landjas09/SPECTRA-MX-1-/BOM/Spectra Mx-1.csv

Reference | Qty | Value | Footprint | Manufacturer_Part_Number | MANUFACTURER
C100,C101,C206,C207,C402 | 5 | 1u | Capacitor_SMD:C_0603_1608Metric
C102,C103,C104,C105,C107 | 5 | 22u | Capacitor_SMD:C_0805_2012Metric
C106 | 1 | DNP | Capacitor_SMD:C_0402_1005Metric
C108,C201,C202,C203,C204,C210,C211,C212,C301,C302,C306,C311,C313,C314,C401,C405 | 16 | 100n | Capacitor_SMD:C_0402_1005Metric
C200,C308,C309,C310,C312,C315,C400 | 7 | 10u | Capacitor_SMD:C_0603_1608Metric
C205 | 1 | 10n | Capacitor_SMD:C_0402_1005Metric
C208,C209 | 2 | 10p | Capacitor_SMD:C_0402_1005Metric
C300,C304,C307,C404 | 4 | 150p | Capacitor_SMD:C_0402_1005Metric
C303,C305,C403,C406 | 4 | 1n | Capacitor_SMD:C_0402_1005Metric
D100 | 1 | GREEN | LED_SMD:LED_0603_1608Metric
D206 | 1 | LED_ARGB | LED_SMD:LED_RGB_Wuerth-PLCC4_3.2x2.8mm_150141M173100
J200 | 1 | Conn_02x05_Odd_Even | Connector_PinHeader_1.27mm:PinHeader_2x05_P1.27mm_Vertical
J201 | 1 | USB_C_Receptacle_USB2.0_16P | Connector_USB:USB_C_Receptacle_GCT_USB4105-xx-A_16P_TopMnt_Horizontal
J300,J400 | 2 | Conn_Coaxial | Connector_Coaxial:BNC_Amphenol_B6252HB-NPP3G-50_Horizontal
L100 | 1 | 100n | Inductor_SMD:L_0402_1005Metric
L101 | 1 | MWSA0603S-150MT | Footprints:INDM7066X300N |  | Shenzhen Sunlord Electronics Co. Ltd.
L200 | 1 | CMF3216F-900-2P-T | Footprints:CMC-1206
L201 | 1 | 10n | Inductor_SMD:L_0402_1005Metric
R100 | 1 | 10R | Resistor_SMD:R_0805_2012Metric
R101 | 1 | 100k | Resistor_SMD:R_0402_1005Metric
R102,R304,R403 | 3 | 22k | Resistor_SMD:R_0402_1005Metric
R103,R104,R105,R300,R306,R307 | 6 | 1k | Resistor_SMD:R_0402_1005Metric
R200,R202,R203,R402 | 4 | 10k | Resistor_SMD:R_0402_1005Metric
R201,R309,R400 | 3 | 0R | Resistor_SMD:R_0402_1005Metric
R204 | 1 | 1k5 | Resistor_SMD:R_0402_1005Metric
R205,R206 | 2 | 5k1 | Resistor_SMD:R_0402_1005Metric
R207,R208,R209 | 3 | 1K | Resistor_SMD:R_0402_1005Metric
R210,R211,R212,R213,R308,R405 | 6 | 49R9 | Resistor_SMD:R_0402_1005Metric
R301,R302 | 2 | 2M2 | Resistor_SMD:R_0402_1005Metric
R303,R401 | 2 | 6k8 | Resistor_SMD:R_0402_1005Metric
R305,R404 | 2 | 12k | Resistor_SMD:R_0402_1005Metric
U100 | 1 | TLV62569DBVR | Footprints:TLV-SOT95P280X145-5N
U101 | 1 | HT7533-1 | Footprints:LDO-SOT89
U102,U300,U301,U401 | 4 | MCP6001U | Package_TO_SOT_SMD:SOT-23-5
U200 | 1 | STM32F103CBTx | Footprints:STM-LQFP-48_7x7mm_P0.5mm
U201 | 1 | USBLC6-2SC6 | Package_TO_SOT_SMD:SOT-23-6
U302 | 1 | ADC141S626CIMM/NOPB | Footprints:SOIC-10-adc141s626
U303 | 1 | REF3033 | Package_TO_SOT_SMD:SOT-23
U400 | 1 | DAC7563SDGSR | Footprints:SOIC-10-adc141s626
Y200 | 1 | 16Mhz | Crystal:Crystal_SMD_3225-4Pin_3.2x2.5mm
D200,D201,D203,D204,D205,D300,D400 | 7 | CDSOD323-T03C | Footprints:SOD2513X114N | CDSOD323-T03C
