landjas09/SPECTRA-MX-1-/BOM/note.txt

manufacturer names and exact manufacturer part numbers (MPNs) have not yet been finalized for all components.
