landjas09/SPECTRA-MX-1-/3D/CDSOD323-T03C.stp

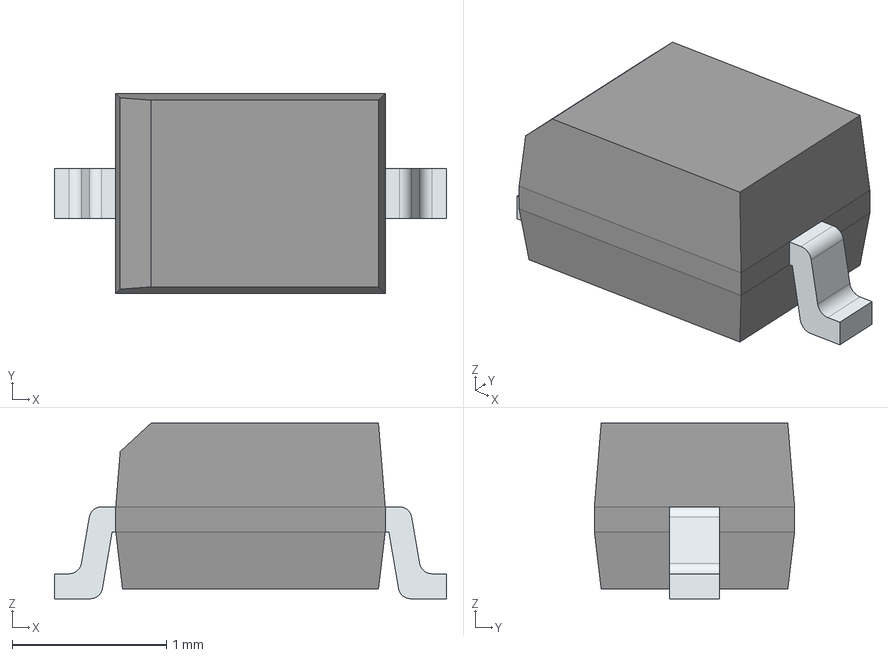
[picture p6: CAD file, 2026-10-12]
3D/CDSOD323-T03C.stp
2.54 x 1.30 x 1.14 mm
FilletPinL
FilletPinR
