landjas09/SPECTRA-MX-1-/3D/WE-CNSW_1206.step

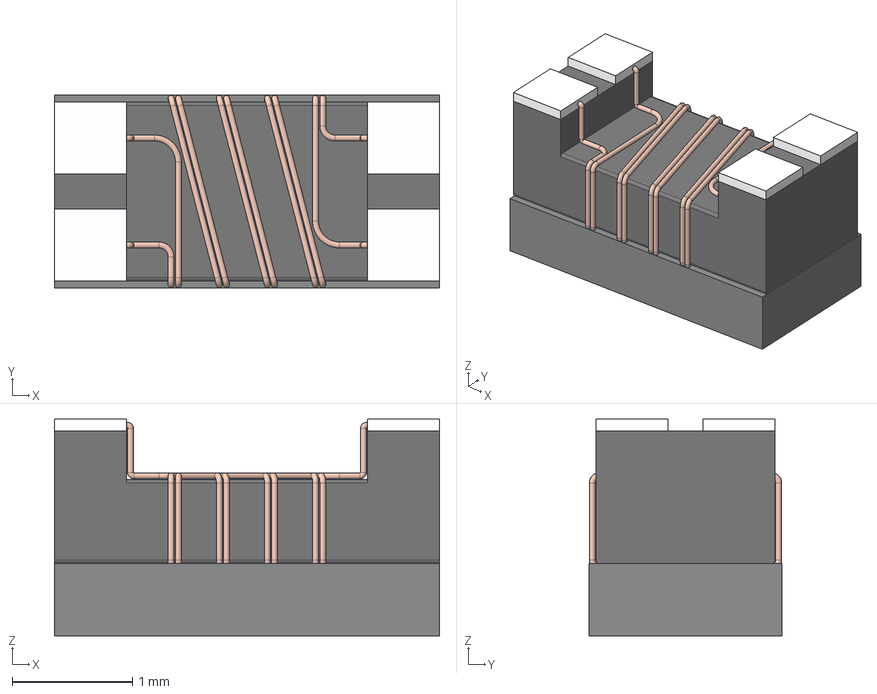
[picture p7: CAD file, 2026-10-12]
3D/WE-CNSW_1206.step
3.20 x 1.60 x 1.80 mm
Gehäuse x 3
Boden
Lötfläche x 4
