landjas09/SPECTRA-MX-1-/3D/CMF3216F-900-2P-T.step

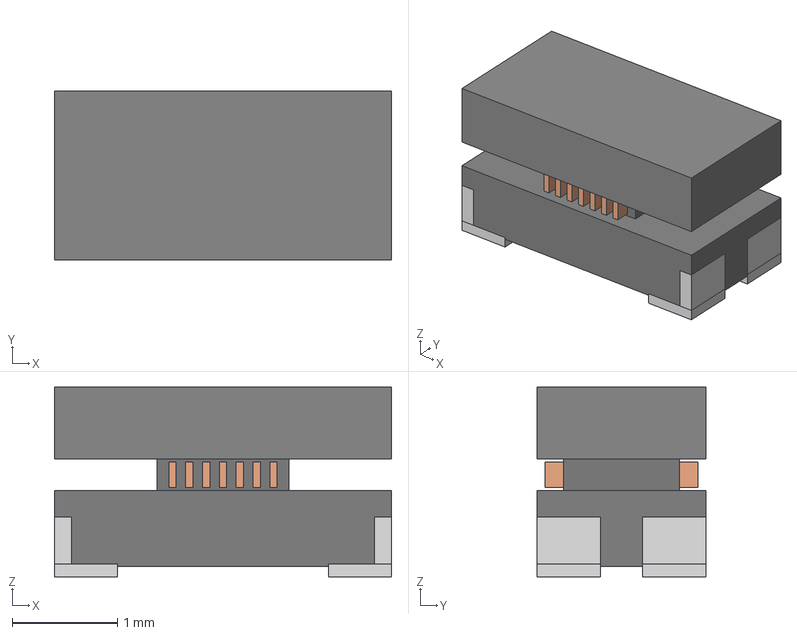
[picture p8: CAD file, 2026-10-12]
3D/CMF3216F-900-2P-T.step
3.20 x 1.60 x 1.80 mm
Lower_Ferrite
Upper_Ferrite
Core
Terminal_-1_-1_foot
Terminal_-1_-1_tab
Terminal_-1_1_foot
Terminal_-1_1_tab
Terminal_1_-1_foot
Terminal_1_-1_tab
Terminal_1_1_foot
Terminal_1_1_tab
CopperWinding_0
CopperWinding_1
CopperWinding_2
CopperWinding_3
CopperWinding_4
CopperWinding_5
CopperWinding_6
