landjas09/SPECTRA-MX-1-/3D/IND_MWSA0603S_SNL.step

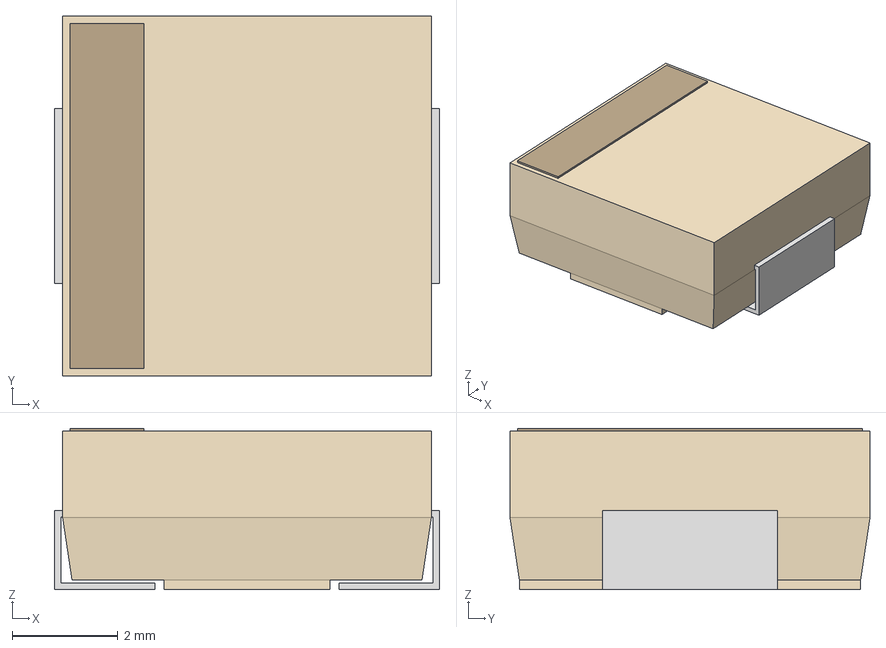
[picture p9: CAD file, 2026-10-12]
3D/IND_MWSA0603S_SNL.step
7.29 x 6.81 x 3.05 mm
