landjas09/SPECTRA-MX-1-/MixedSignal_Analyzer_Generator.kicad_pcb

## KiCad design MixedSignal_Analyzer_Generator.kicad_pcb (2026-10-12)

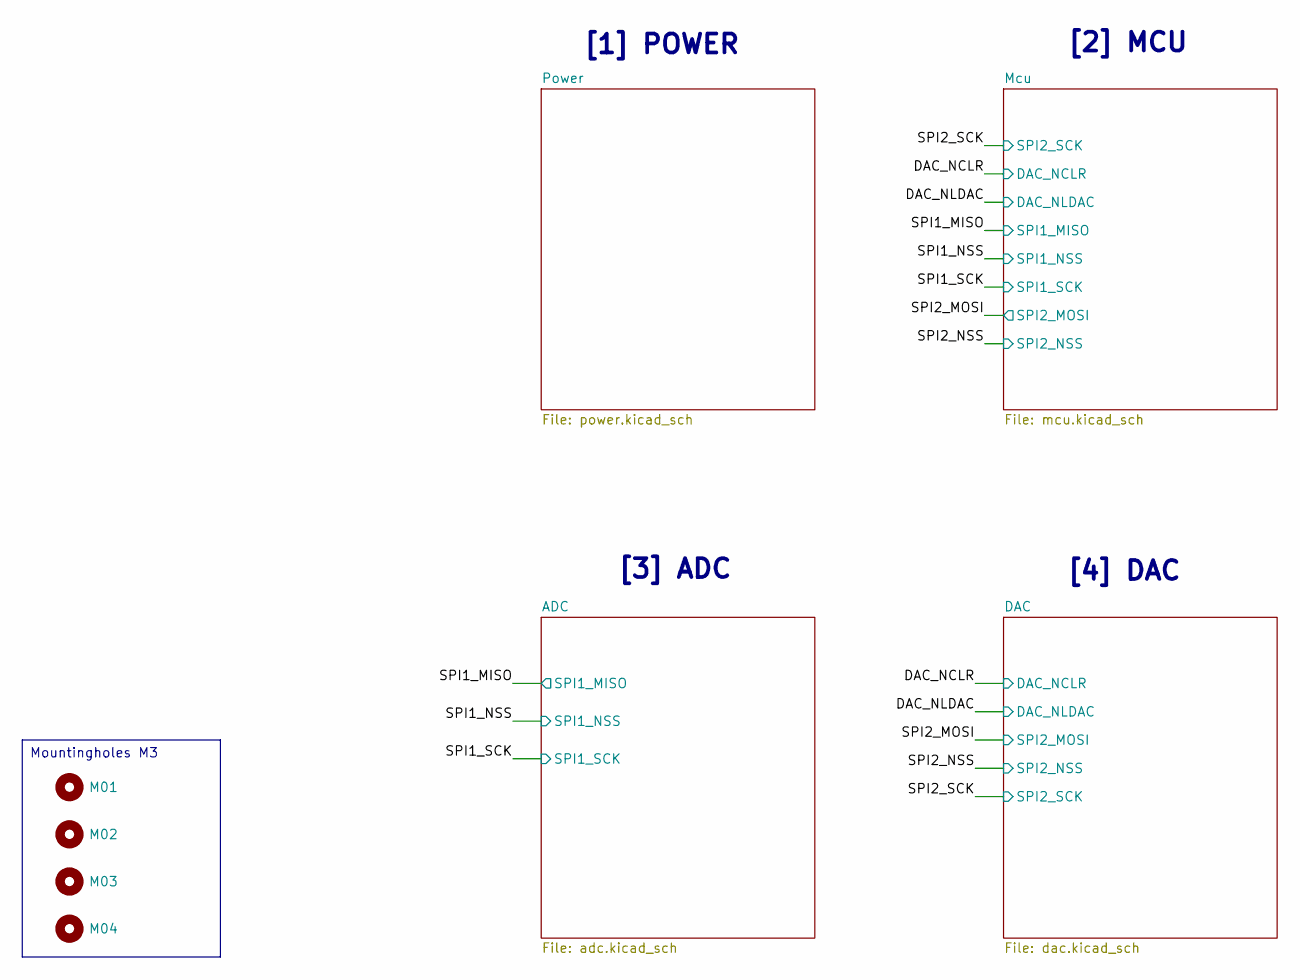
[picture p10: schematic MixedSignal_Analyzer_Generator.kicad_sch]

Parts:
M01, M02, M03, M04: MountingHole; MountingHole_3.2mm_M3

Notes on the sheet:
[3] ADC
[2] MCU
[4] DAC
[1] POWER
Mountingholes M3

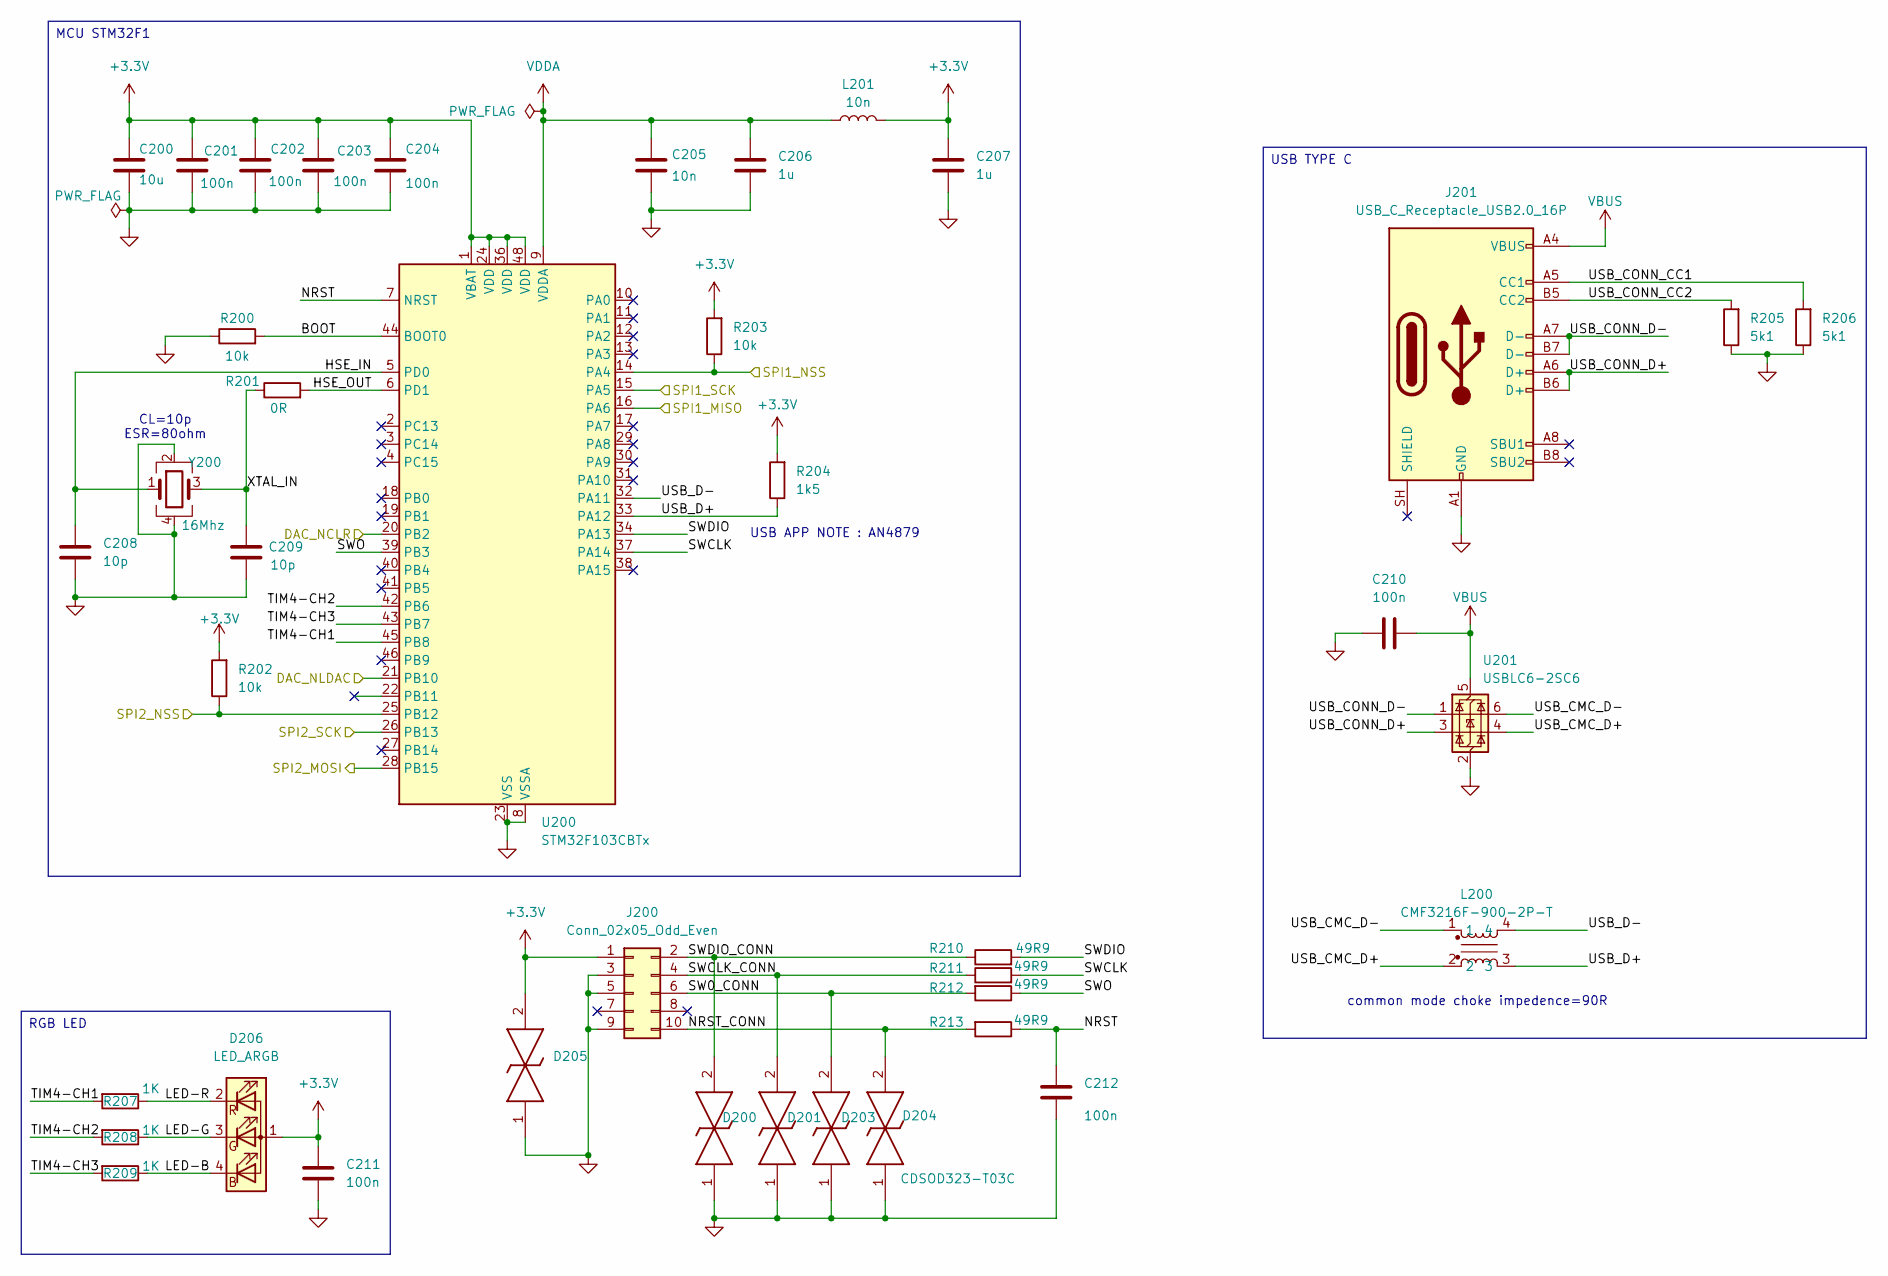
[picture p11: schematic mcu.kicad_sch]

Parts:
C200: 10u; C_0603_1608Metric
C201, C202, C203, C204, C210, C211, C212: 100n; C_0402_1005Metric
C205: 10n; C_0402_1005Metric
C206, C207: 1u; C_0603_1608Metric
C208, C209: 10p; C_0402_1005Metric
D200, D201, D203, D204, D205: CDSOD323-T03C; SOD2513X114N; Mouser Part Number 652-CDSOD323-T03C
D206: LED_ARGB; LED_RGB_Wuerth-PLCC4_3.2x2.8mm_150141M173100
J200: Conn_02x05_Odd_Even; PinHeader_2x05_P1.27mm_Vertical
J201: USB_C_Receptacle_USB2.0_16P; USB_C_Receptacle_GCT_USB4105-xx-A_16P_TopMnt_Horizontal
L200: CMF3216F-900-2P-T; CMC-1206
L201: 10n; L_0402_1005Metric
R200, R202, R203: 10k; R_0402_1005Metric
R201: 0R; R_0402_1005Metric
R204: 1k5; R_0402_1005Metric
R205, R206: 5k1; R_0402_1005Metric
R207, R208, R209: 1K; R_0402_1005Metric
R210, R211, R212, R213: 49R9; R_0402_1005Metric
U200: STM32F103CBTx; STM-LQFP-48_7x7mm_P0.5mm
U201: USBLC6-2SC6; SOT-23-6
Y200: 16Mhz; Crystal_SMD_3225-4Pin_3.2x2.5mm

Connections:
+3.3V: C200.1, C201.1, C202.1, C203.1, C204.1, C207.1, C211.1, D205.2, D206.1 (A), J200.1, L201.2, R202.2, R203.2, R204.2, U200.1 (VBAT), U200.24 (VDD), U200.36 (VDD), U200.48 (VDD); also elsewhere on the board
/DAC_NCLR: U200.20 (PB2); also elsewhere on the board
/DAC_NLDAC: U200.21 (PB10); also elsewhere on the board
/Mcu/BOOT: R200.2, U200.44 (BOOT0)
/Mcu/HSE_IN: C208.1, U200.5 (PD0), Y200.1
/Mcu/HSE_OUT: R201.2, U200.6 (PD1)
/Mcu/LED-B: D206.4 (BK), R209.1
/Mcu/LED-G: D206.3 (GK), R208.1
/Mcu/LED-R: D206.2 (RK), R207.1
/Mcu/NRST: C212.1, R213.1, U200.7 (NRST)
/Mcu/NRST_CONN: D204.2, J200.10, R213.2
/Mcu/SW0_CONN: D203.2, J200.6, R212.2
/Mcu/SWCLK: R211.2, U200.37 (PA14)
/Mcu/SWCLK_CONN: D201.2, J200.4, R211.1
/Mcu/SWDIO: R210.2, U200.34 (PA13)
/Mcu/SWDIO_CONN: D200.2, J200.2, R210.1
/Mcu/SWO: R212.1, U200.39 (PB3)
/Mcu/TIM4-CH1: R207.2, U200.45 (PB8)
/Mcu/TIM4-CH2: R208.2, U200.42 (PB6)
/Mcu/TIM4-CH3: R209.2, U200.43 (PB7)
/Mcu/USB_CMC_D+: L200.2, U201.4 (I/O2)
/Mcu/USB_CMC_D-: L200.1, U201.6 (I/O1)
/Mcu/USB_CONN_CC1: J201.A5 (CC1), R206.2
/Mcu/USB_CONN_CC2: J201.B5 (CC2), R205.2
/Mcu/USB_CONN_D+: J201.A6 (D+), J201.B6 (D+), U201.3 (I/O2)
/Mcu/USB_CONN_D-: J201.A7 (D-), J201.B7 (D-), U201.1 (I/O1)
/Mcu/USB_D+: L200.3, R204.1, U200.33 (PA12)
/Mcu/USB_D-: L200.4, U200.32 (PA11)
/Mcu/XTAL_IN: C209.1, R201.1, Y200.3
/SPI1_MISO: U200.16 (PA6); also elsewhere on the board
/SPI1_NSS: R203.1, U200.14 (PA4); also elsewhere on the board
/SPI1_SCK: U200.15 (PA5); also elsewhere on the board
/SPI2_MOSI: U200.28 (PB15); also elsewhere on the board
/SPI2_NSS: R202.1, U200.25 (PB12); also elsewhere on the board
/SPI2_SCK: U200.26 (PB13); also elsewhere on the board
GND: C200.2, C201.2, C202.2, C203.2, C204.2, C205.2, C206.2, C207.2, C208.2, C209.2, C210.2, C211.2, C212.2, D200.1, D201.1, D203.1, D204.1, D205.1, J200.3, J200.5, J200.9, J201.A1 (GND), J201.A12 (GND), J201.B1 (GND), J201.B12 (GND), R200.1, R205.1, R206.1, U200.8 (VSSA), U200.23 (VSS), U200.35 (VSS), U200.47 (VSS), U201.2 (GND), Y200.2 (G), Y200.4 (G); also elsewhere on the board
VBUS: C210.1, J201.A4 (VBUS), J201.A9 (VBUS), J201.B4 (VBUS), J201.B9 (VBUS), U201.5 (VBUS); also elsewhere on the board
VDDA: C205.1, C206.1, L201.1, U200.9 (VDDA)

Notes on the sheet:
USB APP NOTE : AN4879
common mode choke impedence=90R
CL=10p ESR=80ohm
MCU STM32F1
RGB LED
USB TYPE C

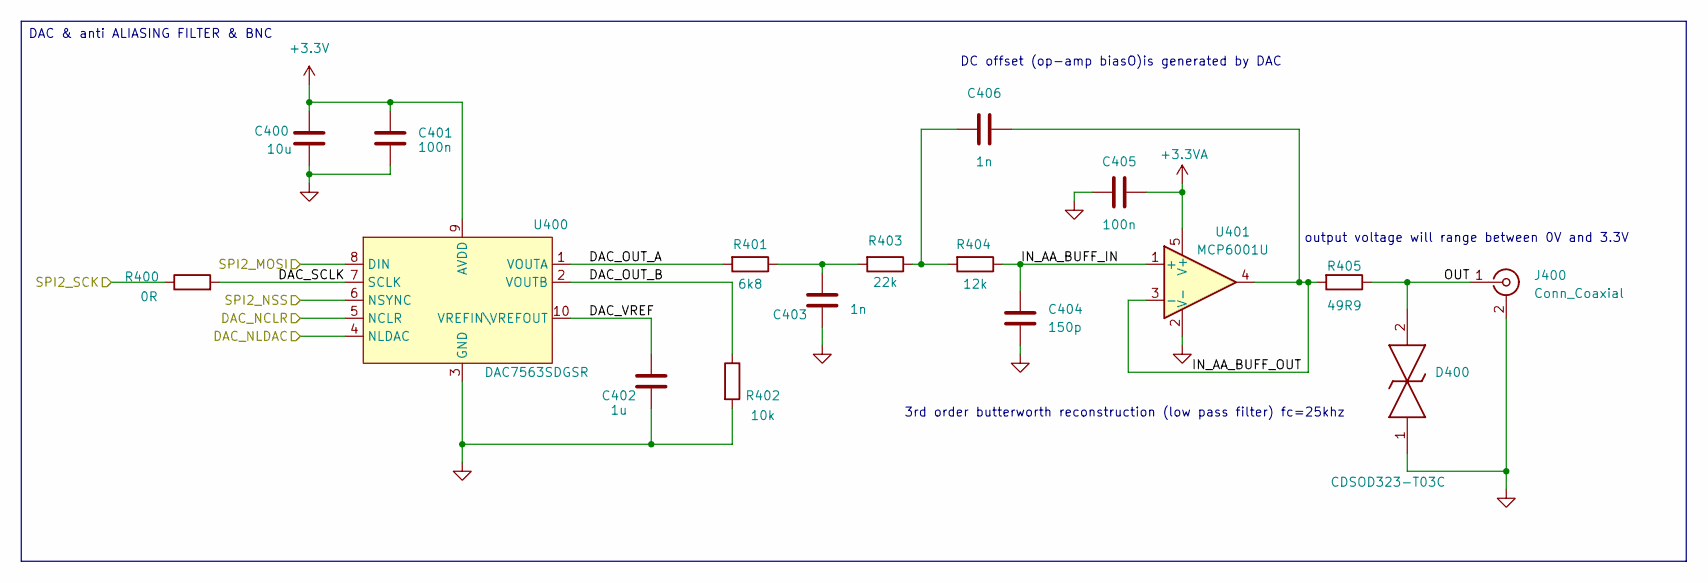
[picture p12: schematic dac.kicad_sch]

Parts:
C400: 10u; C_0603_1608Metric
C401, C405: 100n; C_0402_1005Metric
C402: 1u; C_0603_1608Metric
C403, C406: 1n; C_0402_1005Metric
C404: 150p; C_0402_1005Metric
D400: CDSOD323-T03C; SOD2513X114N; Mouser Part Number 652-CDSOD323-T03C
J400: Conn_Coaxial; BNC_Amphenol_B6252HB-NPP3G-50_Horizontal
R400: 0R; R_0402_1005Metric
R401: 6k8; R_0402_1005Metric
R402: 10k; R_0402_1005Metric
R403: 22k; R_0402_1005Metric
R404: 12k; R_0402_1005Metric
R405: 49R9; R_0402_1005Metric
U400: DAC7563SDGSR; SOIC-10-adc141s626
U401: MCP6001U; SOT-23-5

Connections:
+3.3V: C400.1, C401.1, U400.9 (AVDD); also elsewhere on the board
+3.3VA: C405.2, U401.5 (V+); also elsewhere on the board
/DAC/DAC_OUT_A: R401.2, U400.1 (VOUTA)
/DAC/DAC_OUT_B: R402.1, U400.2 (VOUTB)
/DAC/DAC_SCLK: R400.2, U400.7 (SCLK)
/DAC/DAC_VREF: C402.1, U400.10 (VREFIN\VREFOUT)
/DAC/IN_AA_BUFF_IN: C404.1, R404.1, U401.1 (+)
/DAC/IN_AA_BUFF_OUT: C406.2, R405.2, U401.3 (-), U401.4
/DAC/OUT: D400.2, J400.1 (In), R405.1
/DAC_NCLR: U400.5 (NCLR); also elsewhere on the board
/DAC_NLDAC: U400.4 (NLDAC); also elsewhere on the board
/SPI2_MOSI: U400.8 (DIN); also elsewhere on the board
/SPI2_NSS: U400.6 (NSYNC); also elsewhere on the board
/SPI2_SCK: R400.1; also elsewhere on the board
GND: C400.2, C401.2, C402.2, C403.2, C404.2, C405.1, D400.1, J400.2 (Ext), R402.2, U400.3 (GND), U401.2 (V-); also elsewhere on the board
unnamed: C403.1, R401.1, R403.2
unnamed: C406.1, R403.1, R404.2

Notes on the sheet:
output voltage will range between 0V and 3.3V
DC offset (op-amp biasO)is generated by DAC
3rd order butterworth reconstruction (low pass filter) fc=25khz
DAC & anti ALIASING FILTER & BNC

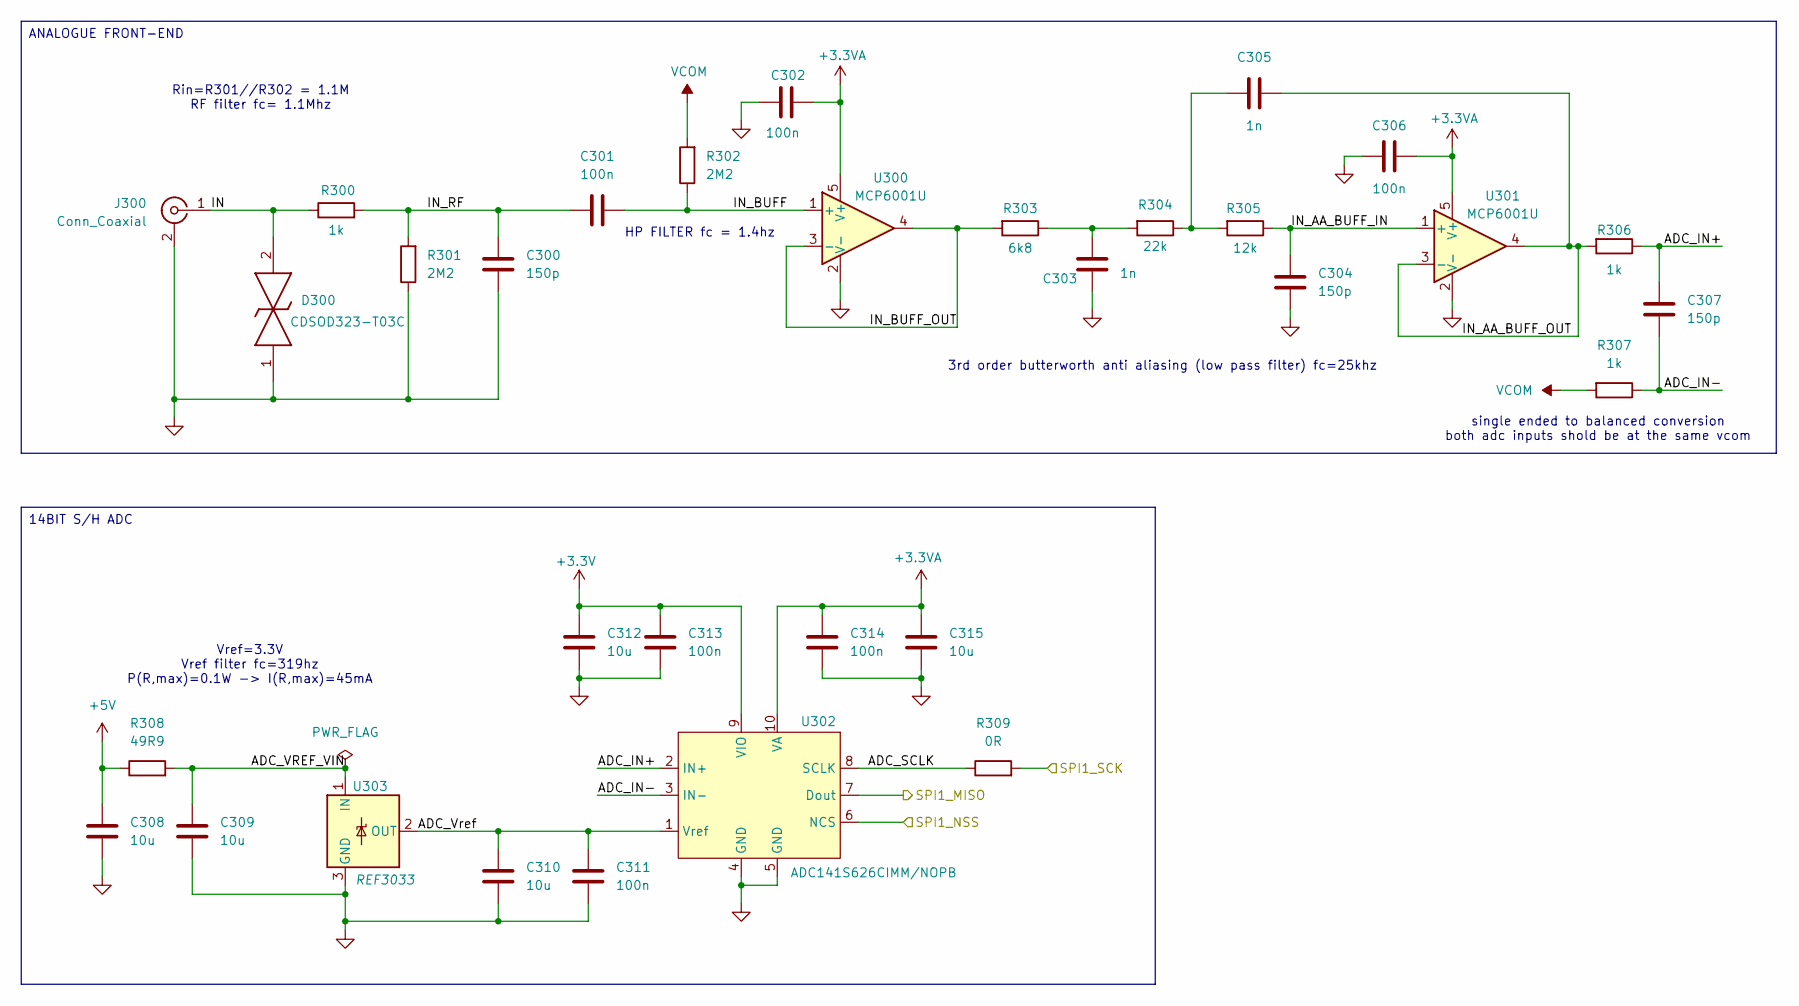
[picture p13: schematic adc.kicad_sch]

Parts:
C300, C304, C307: 150p; C_0402_1005Metric
C301, C302, C306, C311, C313, C314: 100n; C_0402_1005Metric
C303, C305: 1n; C_0402_1005Metric
C308, C309, C310, C312, C315: 10u; C_0603_1608Metric
D300: CDSOD323-T03C; SOD2513X114N; Mouser Part Number 652-CDSOD323-T03C
J300: Conn_Coaxial; BNC_Amphenol_B6252HB-NPP3G-50_Horizontal
R300, R306, R307: 1k; R_0402_1005Metric
R301, R302: 2M2; R_0402_1005Metric
R303: 6k8; R_0402_1005Metric
R304: 22k; R_0402_1005Metric
R305: 12k; R_0402_1005Metric
R308: 49R9; R_0402_1005Metric
R309: 0R; R_0402_1005Metric
U300, U301: MCP6001U; SOT-23-5
U302: ADC141S626CIMM/NOPB; SOIC-10-adc141s626
U303: REF3033; SOT-23

Connections:
+3.3V: C312.1, C313.1, U302.9 (VIO); also elsewhere on the board
+3.3VA: C302.2, C306.2, C314.1, C315.1, U300.5 (V+), U301.5 (V+), U302.10 (VA); also elsewhere on the board
+5V: C308.1, R308.1; also elsewhere on the board
/ADC/ADC_IN+: C307.1, R306.1, U302.2 (IN+)
/ADC/ADC_IN-: C307.2, R307.1, U302.3 (IN-)
/ADC/ADC_SCLK: R309.1, U302.8 (SCLK)
/ADC/ADC_VREF_VIN: C309.1, R308.2, U303.1 (IN)
/ADC/ADC_Vref: C310.1, C311.1, U302.1 (Vref), U303.2 (OUT)
/ADC/IN: D300.2, J300.1 (In), R300.1
/ADC/IN_AA_BUFF_IN: C304.1, R305.1, U301.1 (+)
/ADC/IN_AA_BUFF_OUT: C305.2, R306.2, U301.3 (-), U301.4
/ADC/IN_BUFF: C301.2, R302.1, U300.1 (+)
/ADC/IN_BUFF_OUT: R303.2, U300.3 (-), U300.4
/ADC/IN_RF: C300.1, C301.1, R300.2, R301.2
/SPI1_MISO: U302.7 (Dout); also elsewhere on the board
/SPI1_NSS: U302.6 (NCS); also elsewhere on the board
/SPI1_SCK: R309.2; also elsewhere on the board
GND: C300.2, C302.1, C303.2, C304.2, C306.1, C308.2, C309.2, C310.2, C311.2, C312.2, C313.2, C314.2, C315.2, D300.1, J300.2 (Ext), R301.1, U300.2 (V-), U301.2 (V-), U302.4 (GND), U302.5 (GND), U303.3 (GND); also elsewhere on the board
unnamed: C303.1, R303.1, R304.2
unnamed: C305.1, R304.1, R305.2
VCOM: R302.2, R307.2; also elsewhere on the board

Notes on the sheet:
Vref=3.3V Vref filter fc=319hz P(R,max)=0.1W -> I(R,max)=45mA
single ended to balanced conversion both adc inputs shold be at the same vcom
Rin=R301//R302 = 1.1M RF filter fc= 1.1Mhz
HP FILTER fc = 1.4hz
3rd order butterworth anti aliasing (low pass filter) fc=25khz
ANALOGUE FRONT-END
14BIT S/H ADC

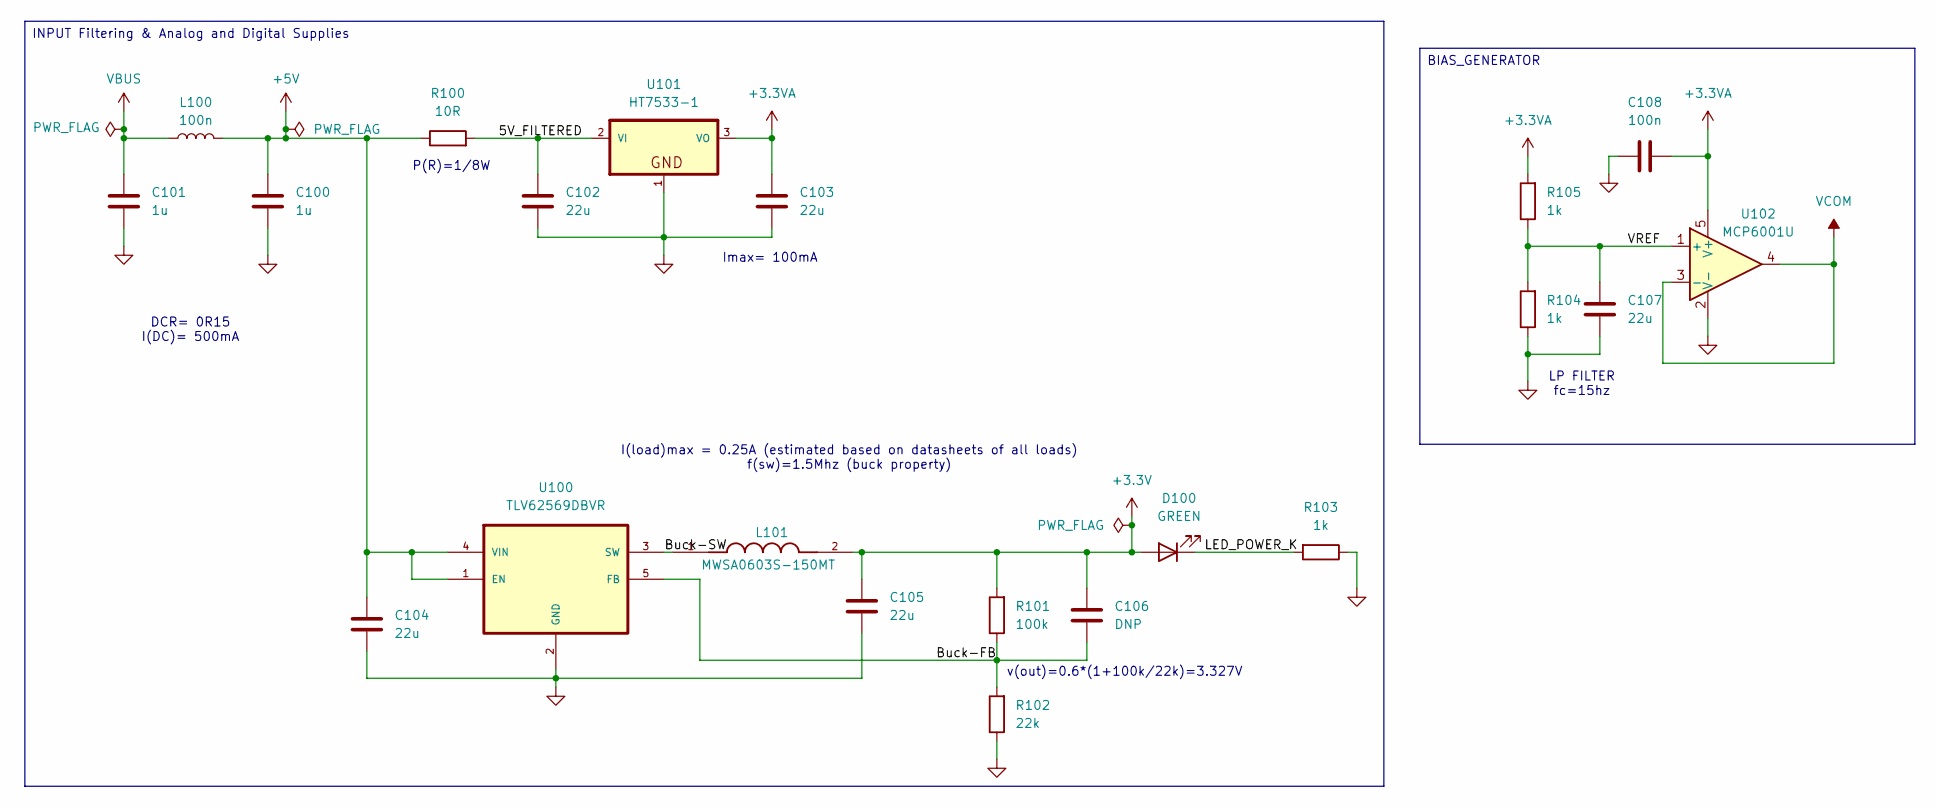
[picture p14: schematic power.kicad_sch]

Parts:
C100, C101: 1u; C_0603_1608Metric
C102, C103, C104, C105, C107: 22u; C_0805_2012Metric
C106: DNP; C_0402_1005Metric
C108: 100n; C_0402_1005Metric
D100: GREEN; LED_0603_1608Metric
L100: 100n; L_0402_1005Metric
L101: MWSA0603S-150MT; INDM7066X300N; PARTREV 2022/10/12
R100: 10R; R_0805_2012Metric
R101: 100k; R_0402_1005Metric
R102: 22k; R_0402_1005Metric
R103, R104, R105: 1k; R_0402_1005Metric
U100: TLV62569DBVR; TLV-SOT95P280X145-5N
U101: HT7533-1; LDO-SOT89
U102: MCP6001U; SOT-23-5

Connections:
+3.3V: C105.1, C106.1, D100.2 (A), L101.2, R101.2; also elsewhere on the board
+3.3VA: C103.1, C108.2, R105.2, U101.3 (VO), U102.5 (V+); also elsewhere on the board
+5V: C100.1, C104.1, L100.2, R100.1, U100.1 (EN), U100.4 (VIN); also elsewhere on the board
/Power/5V_FILTERED: C102.1, R100.2, U101.2 (VI), U101.2@1 (VI)
/Power/Buck-FB: C106.2, R101.1, R102.2, U100.5 (FB)
/Power/Buck-SW: L101.1, U100.3 (SW)
/Power/LED_POWER_K: D100.1 (K), R103.2
/Power/VREF: C107.1, R104.2, R105.1, U102.1 (+)
GND: C100.2, C101.2, C102.2, C103.2, C104.2, C105.2, C107.2, C108.1, R102.1, R103.1, R104.1, U100.2 (GND), U101.1, U102.2 (V-); also elsewhere on the board
VBUS: C101.1, L100.1; also elsewhere on the board
VCOM: U102.3 (-), U102.4; also elsewhere on the board

Notes on the sheet:
DCR= 0R15 I(DC)= 500mA
Imax= 100mA
v(out)=0.6*(1+100k/22k)=3.327V
LP FILTER fc=15hz
I(load)max = 0.25A (estimated based on datasheets of all loads) f(sw)=1.5Mhz (buck property)
P(R)=1/8W
INPUT Filtering & Analog and Digital Supplies
BIAS_GENERATOR

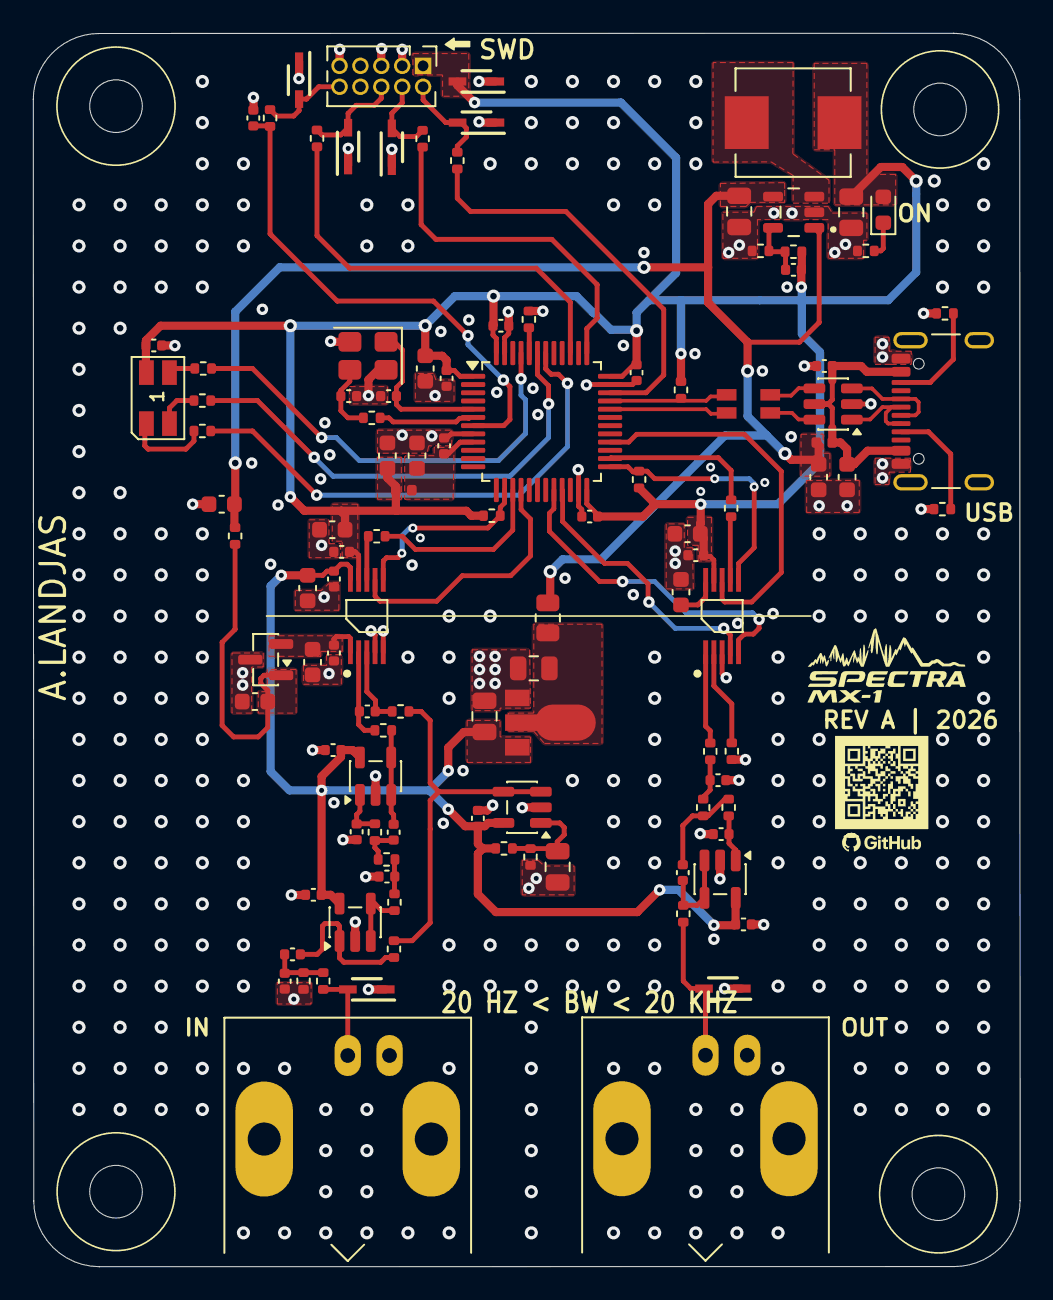
[picture p15: board MixedSignal_Analyzer_Generator.kicad_pcb from above]

Board: 4 copper layers, 60.0 x 75.0 mm, 114 parts (0 on the bottom side), 68 nets.
